funwun/eink_test/images/eink_test_setup.jpg

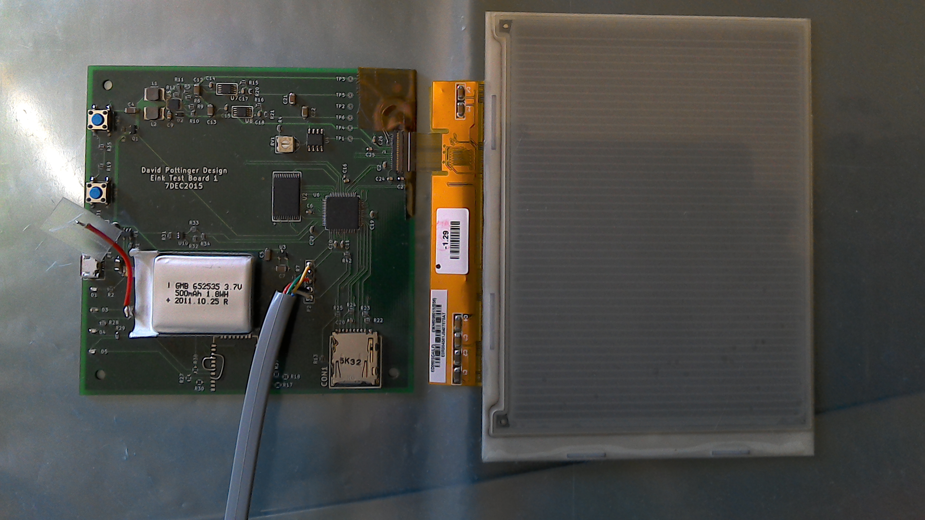
images/eink_test_setup.jpg
