funwun/eink_test/images/eink_raw_boards.jpg

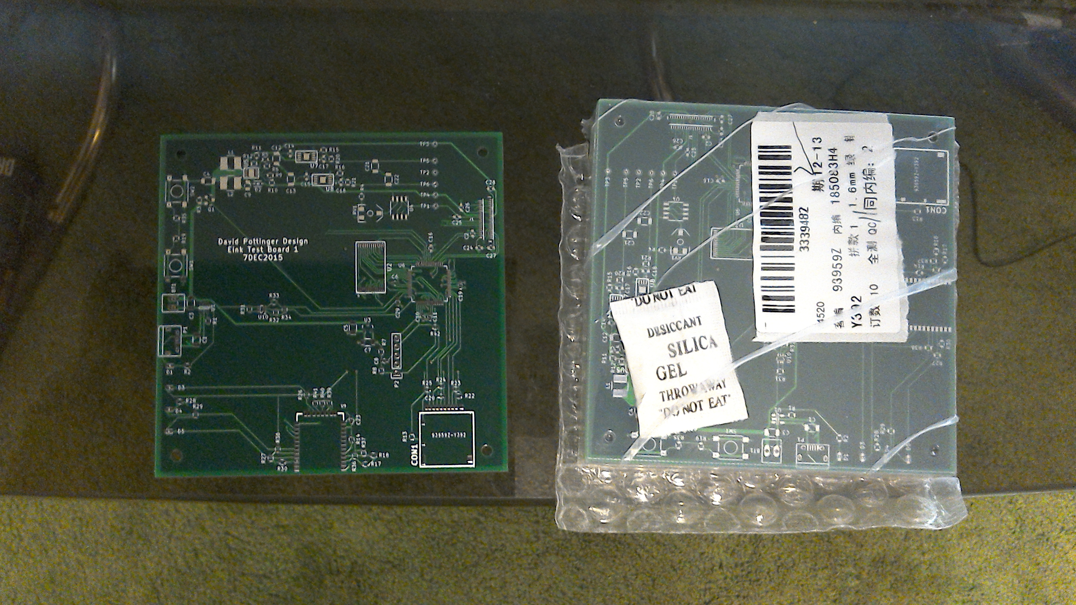
images/eink_raw_boards.jpg
