funwun/eink_test/images/eink_layout_1.png

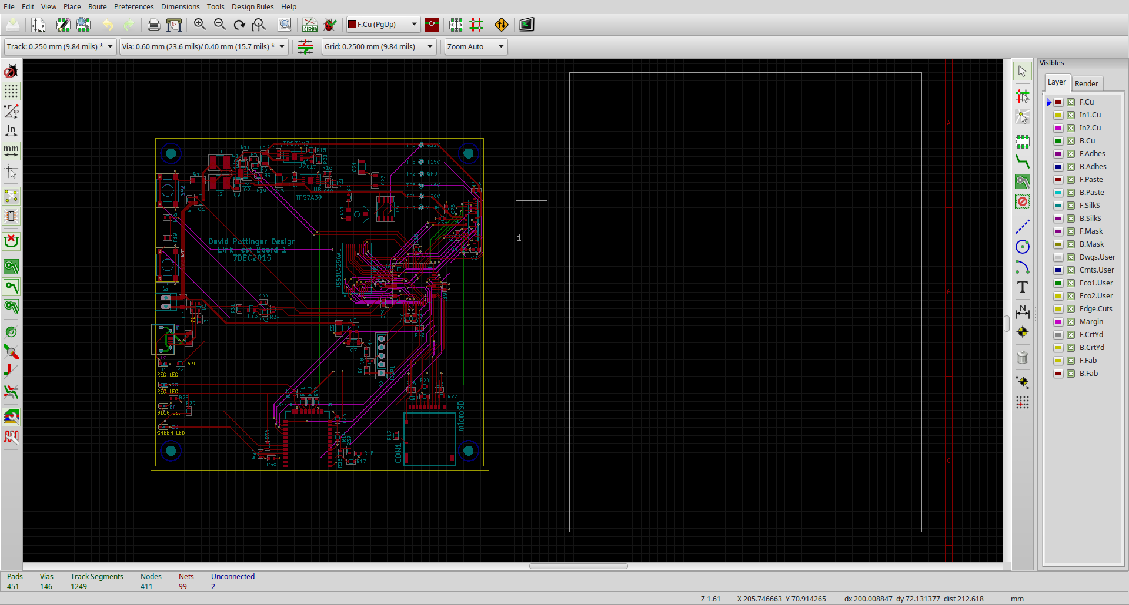
images/eink_layout_1.png
