funwun/eink_test/images/eink_schematic_1.png

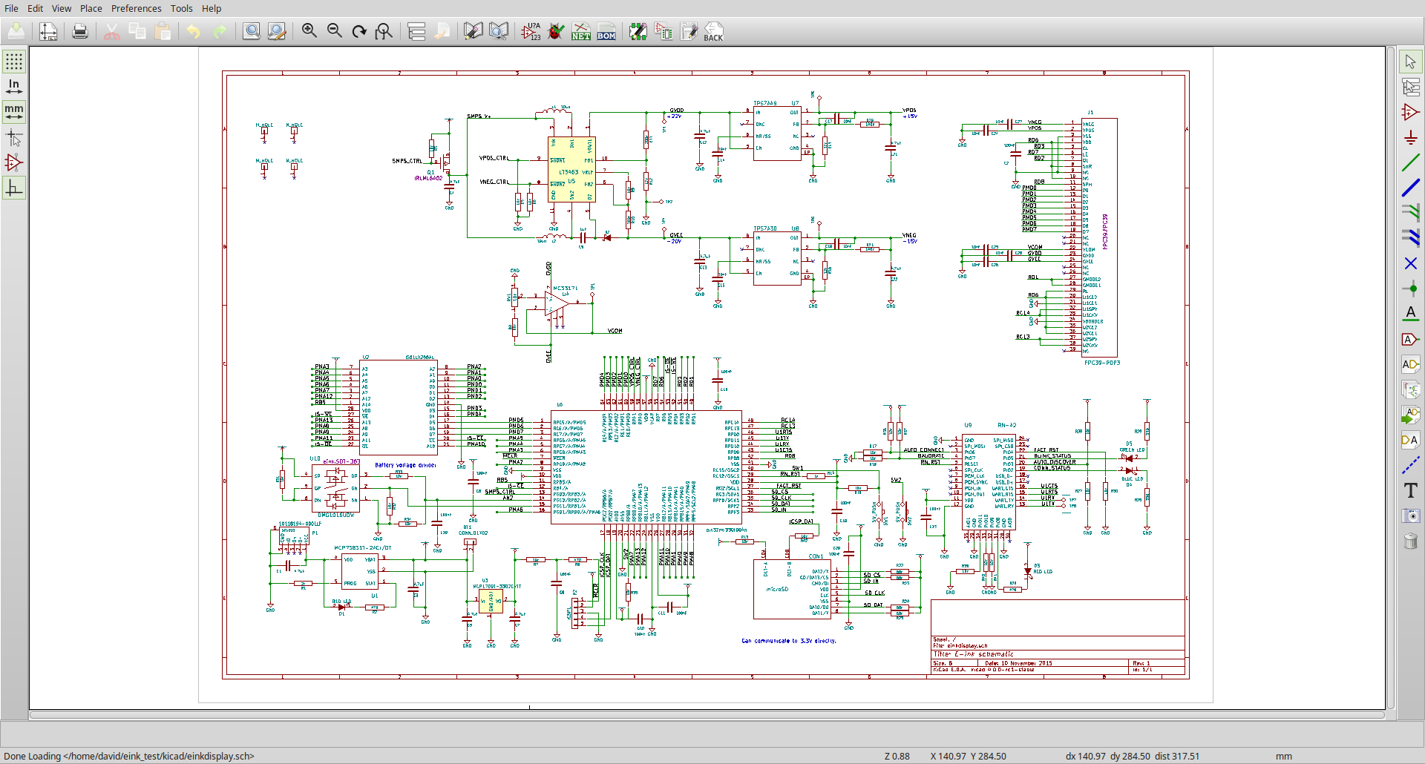
images/eink_schematic_1.png
