funwun/eink_test/kicad/RN-42.dxf

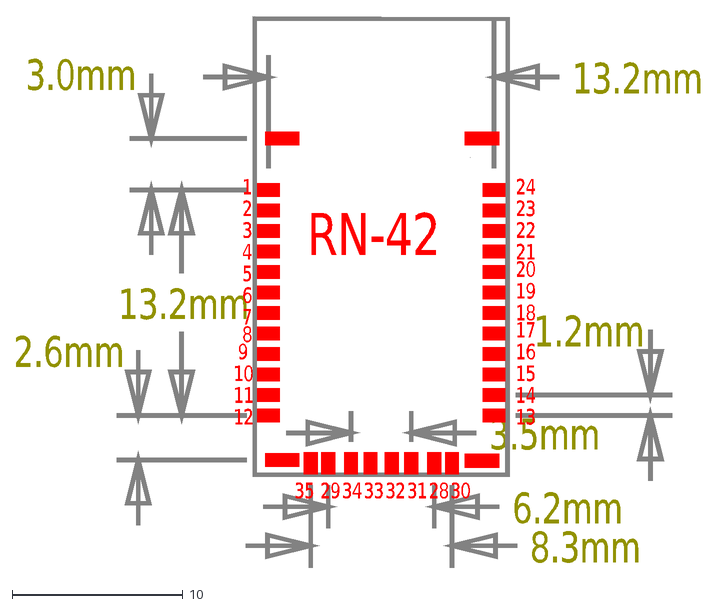
[picture p5: CAD file, 2016-03-12]
kicad/RN-42.dxf
13.2mm
1.2mm
2.6mm
3.0mm
8.3mm
6.2mm
3.5mm
1
2
3
4
5
6
7
8
9
10
11
12
24
23
22
21
20
19
18
14
13
15
17
16
35
29
34
33
32
31
28
30
RN-42
