funwun/eink_test/(list of files, drawings)

Other design files:
kicad/Dwl-Altium-PCB-Footprint-Library.pcblib
