funwun/eink_test/kicad/einkdisplay.kicad_pcb

## KiCad design kicad/einkdisplay.kicad_pcb (2016-03-12)

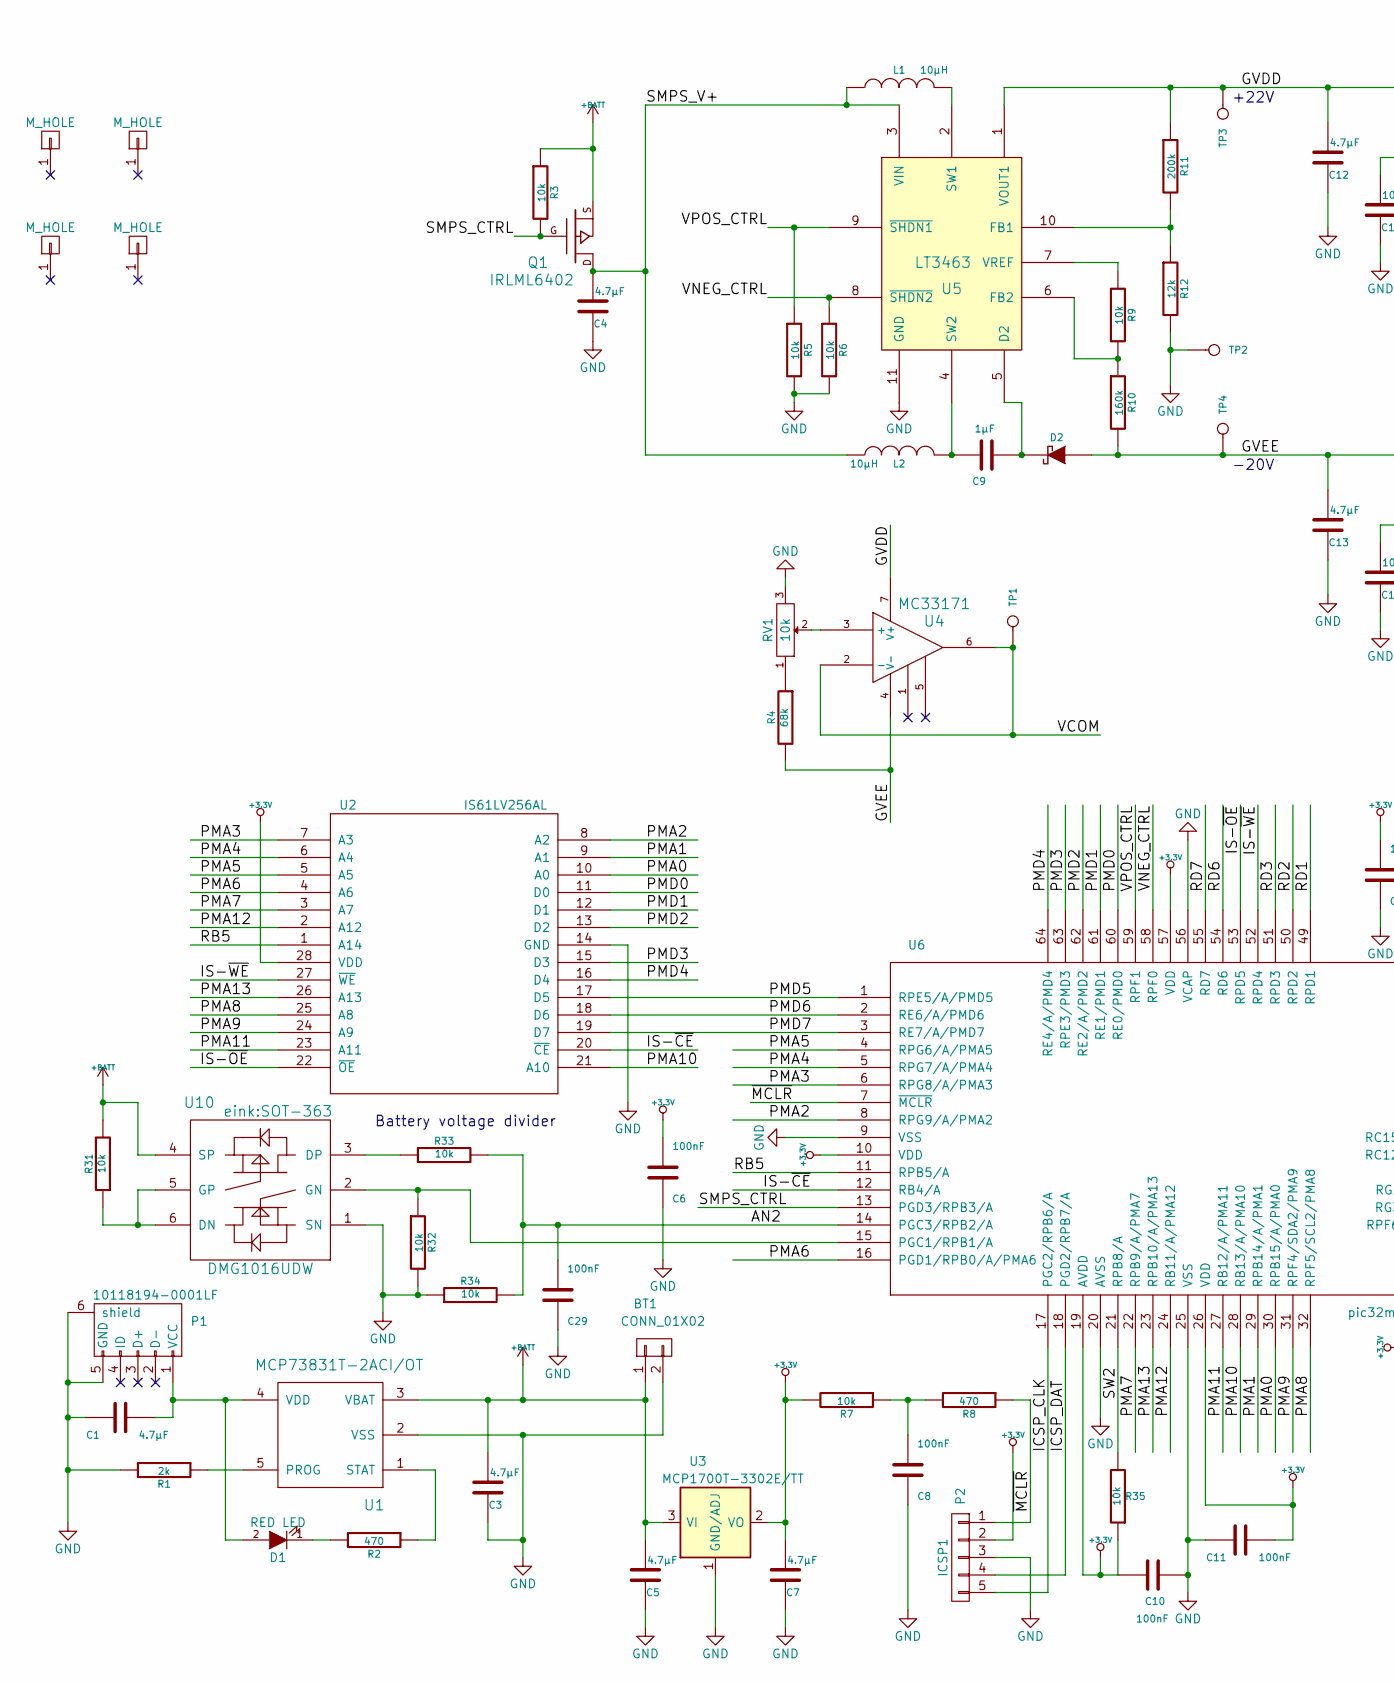
[picture p6: schematic einkdisplay.sch, E-ink schematic, part in row 1, column 1]

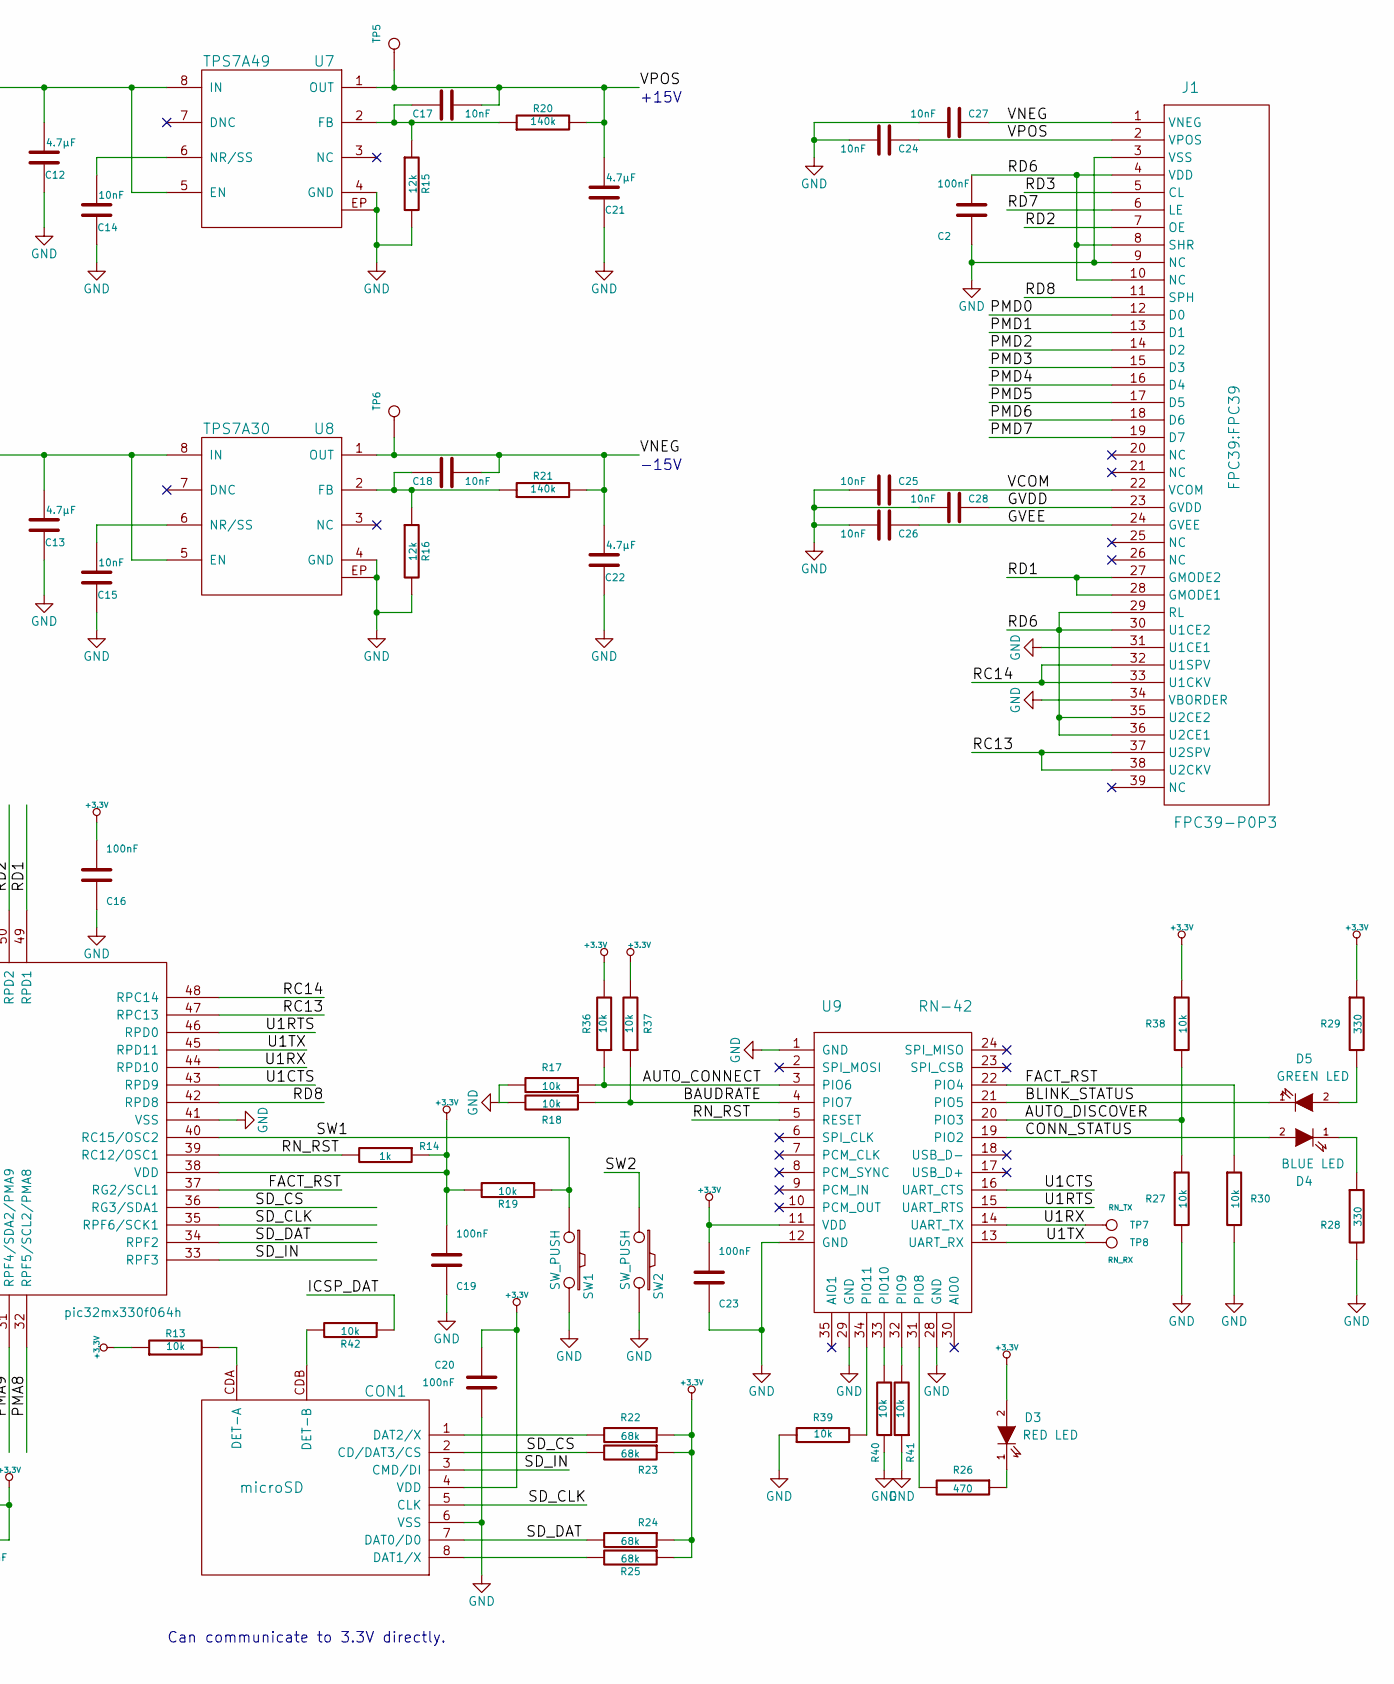
[picture p7: schematic einkdisplay.sch, E-ink schematic, part in row 1, column 2]

Parts:
BT1: CONN_01X02; PINHEAD1-2
C1, C3, C4, C5, C7, C12, C13, C21, C22: 4.7µF; C_1206; Rating 50V; MFG_PN UMK316AB7475KL-T
C2, C6, C8, C10, C11, C16, C19, C20, C23, C29: 100nF; C_0603
C9: 1µF; C_0805; Rating 50V; MFG_PN GRM219R61H105KA73D
C14, C15, C17, C18, C24, C25, C26, C27, C28: 10nF; C_0603; Rating 50V; MFG_PN GRM188R71H103KA01D
CON1: microSD; microSD_std_top; MFG_PN DM3AT-SF-PEJM5
D1, D3: RED LED; LED-0603
D2: DIODESCH; SOD-323-inv; MFG_PN 1N4148WX-TP
D4: BLUE LED; LED-0603
D5: GREEN LED; LED-0603
J1: FPC39-P0P3; FPC39; MFG_PN FH26-39S-0.3SHW(05)
L1, L2: 10µH; NR4018_HandSoldering; MFG_PN LQH44PN100MP0L
MH1, MH2, MH3, MH4: M_HOLE; MountingHole_3mm
P1: 10118194-0001LF; USB_Micro-B; MFG_PN 10118194-0001LF
P2: ICSP1; Pin_Header_Straight_1x05
Q1: 3A; SOT-23_IRLML6402; MFG_PN IRLML6402
R1: 2k; R_0603
R2, R8, R26: 470; R_0603
R3, R5, R6, R7, R9, R13, R17, R18, R19, R27, R30, R31, R32, R33, R34, R35, R36, R37, R38, R39, R40, R41, R42: 10k; R_0603
R4, R22, R23, R24, R25: 68k; R_0603
R10: 160k; R_0603
R11: 200k; R_0603
R12, R15, R16: 12k; R_0603
R14: 1k; R_0603
R20, R21: 140k; R_0603
R28, R29: 330; R_0603
RV1: 10k; POT_SMD; MFG_PN 3314G-1-103E
SW1, SW2: SW_PUSH; SW_SPST_PTS645; MFG_PN PTS645SM43SMTR92 LFS
TP1: VCOM; PINTST
TP2: GND; PINTST
TP3: +22V; PINTST
TP4: -20V; PINTST
TP5: +15V; PINTST
TP6: -15V; PINTST
TP7: RN_TX; PINTST
TP8: RN_RX; PINTST
U1: MCP73831T-2ACI/OT; SOT-23-5
U2: IS61LV256AL; 28TSOP-I; MFG_PN IS61LV256AL-10TLI
U3: MCP1700T-3302E/TT; SOT-23
U4: MC33171; SOIC-8_3.9x4.9mm_Pitch1.27mm; MFG_PN MC33171DT
U5: LT3463; 10DFN-3x3; MFG_PN LT3463EDD#PBF
U6: pic32mx330f064h; LQFP-64_10x10mm_Pitch0.5mm
U7: TPS7A49; 8MSOP; MFG_PN TPS7A4901DGNR
U8: TPS7A30; 8MSOP; MFG_PN TPS7A3001DGNR
U9: RN-42; RN-41; MFG_PN RN42-I/RM
U10: DMG1016UDW; SOT-363; MFG_PN DMG1016UDW-7

Connections:
+3.3V: C6.1, C7.1, C10.2, C11.1, C16.1, C19.1, C20.2, C23.1, CON1.4 (VDD), D3.2 (A), P2.2, R7.2, R13.1, R14.1, R19.2, R22.1, R23.1, R24.1, R25.1, R29.1, R35.1, R36.2, R37.2, R38.1, U2.28 (VDD), U3.2 (VO), U6.10 (VDD), U6.19 (AVDD), U6.26 (VDD), U6.38 (VDD), U6.57 (VDD), U9.11 (VDD); also elsewhere on the board
+BATT: BT1.1, C3.1, C5.1, Q1.S, R3.1, R31.2, U1.3 (VBAT), U3.3 (VI), U10.4 (SP)
/AN2: C29.1, R33.2, R34.2, U6.14 (PGC3/RPB2/A)
/AUTO_CONNECT: R17.1, R36.1, U9.3 (PIO6)
/AUTO_DISCOVER: R27.1, R38.2, U9.20 (PIO3)
/BAUDRATE: R18.1, R37.1, U9.4 (PIO7)
/BLINK_STATUS: D5.1 (K), U9.21 (PIO5); also elsewhere on the board
/CONN_STATUS: D4.2 (A), U9.19 (PIO2); also elsewhere on the board
/FACT_RST: R30.1, U6.37 (RG2/SCL1), U9.22 (PIO4)
/GVDD: C12.1, C28.2, J1.23 (GVDD), R11.1, TP3.1, U4.7 (V+), U5.1 (VOUT1), U7.5 (EN), U7.8 (IN)
/GVEE: C13.1, C26.2, D2.1 (A), J1.24 (GVEE), R4.2, R10.2, TP4.1, U4.4 (V-), U8.5 (EN), U8.8 (IN)
/ICSP_CLK: P2.5, U6.17 (PGC2/RPB6/A)
/ICSP_DAT: P2.4, R42.1, U6.18 (PGD2/RPB7/A)
/IS-~CE: U2.20 (~CE), U6.12 (RB4/A)
/IS-~OE: U2.22 (~OE), U6.53 (RPD5)
/IS-~WE: U2.27 (~WE), U6.52 (RPD4)
/PMA0: U2.10 (A0), U6.30 (RPB15/A/PMA0)
/PMA1: U2.9 (A1), U6.29 (RPB14/A/PMA1)
/PMA2: U2.8 (A2), U6.8 (RPG9/A/PMA2)
/PMA3: U2.7 (A3), U6.6 (RPG8/A/PMA3)
/PMA4: U2.6 (A4), U6.5 (RPG7/A/PMA4)
/PMA5: U2.5 (A5), U6.4 (RPG6/A/PMA5)
/PMA6: U2.4 (A6), U6.16 (PGD1/RPB0/A/PMA6)
/PMA7: U2.3 (A7), U6.22 (RPB9/A/PMA7)
/PMA8: U2.25 (A8), U6.32 (RPF5/SCL2/PMA8)
/PMA9: U2.24 (A9), U6.31 (RPF4/SDA2/PMA9)
/PMA10: U2.21 (A10), U6.28 (RB13/A/PMA10)
/PMA11: U2.23 (A11), U6.27 (RB12/A/PMA11)
/PMA12: U2.2 (A12), U6.24 (RB11/A/PMA12)
/PMA13: U2.26 (A13), U6.23 (RPB10/A/PMA13)
/PMD0: J1.12 (D0), U2.11 (D0), U6.60 (RE0/PMD0)
/PMD1: J1.13 (D1), U2.12 (D1), U6.61 (RE1/PMD1)
/PMD2: J1.14 (D2), U2.13 (D2), U6.62 (RE2/A/PMD2)
/PMD3: J1.15 (D3), U2.15 (D3), U6.63 (RPE3/PMD3)
/PMD4: J1.16 (D4), U2.16 (D4), U6.64 (RE4/A/PMD4)
/PMD5: J1.17 (D5), U2.17 (D5), U6.1 (RPE5/A/PMD5)
/PMD6: J1.18 (D6), U2.18 (D6), U6.2 (RE6/A/PMD6)
/PMD7: J1.19 (D7), U2.19 (D7), U6.3 (RE7/A/PMD7)
/RB5: U2.1 (A14), U6.11 (RPB5/A)
/RC13: J1.37 (U2SPV), J1.38 (U2CKV), U6.47 (RPC13)
/RC14: J1.32 (U1SPV), J1.33 (U1CKV), U6.48 (RPC14)
/RD1: J1.27 (GMODE2), J1.28 (GMODE1), U6.49 (RPD1)
/RD2: J1.7 (OE), U6.50 (RPD2)
/RD3: J1.5 (CL), U6.51 (RPD3)
/RD6: C2.1, J1.4 (VDD), J1.8 (SHR), J1.10 (NC), J1.29 (RL), J1.30 (U1CE2), J1.35 (U2CE2), J1.36 (U2CE1), U6.54 (RD6)
/RD7: J1.6 (LE), U6.55 (RD7)
/RD8: J1.11 (SPH), U6.42 (RPD8)
/RN_RST: R14.2, U6.39 (RC12/OSC1), U9.5 (RESET)
/SD_CLK: CON1.5 (CLK), U6.35 (RPF6/SCK1)
/SD_CS: CON1.2 (CD/DAT3/CS), R23.2, U6.36 (RG3/SDA1)
/SD_DAT: CON1.7 (DAT0/D0), R24.2, U6.34 (RPF2)
/SD_IN: CON1.3 (CMD/DI), U6.33 (RPF3)
/SMPS_CTRL: Q1.G, R3.2, U6.13 (PGD3/RPB3/A)
/SMPS_V+: C4.1, L1.1, L2.1, Q1.D, U5.3 (VIN)
/SW1: R19.1, SW1.1, U6.40 (RC15/OSC2); also elsewhere on the board
/SW2: R35.2, SW2.1, U6.21 (RPB8/A); also elsewhere on the board
/U1CTS: U6.43 (RPD9), U9.16 (UART_CTS)
/U1RTS: U6.46 (RPD0), U9.15 (UART_RTS)
/VCOM: C25.2, J1.22 (VCOM), TP1.1, U4.2 (-), U4.6
/VNEG: C18.1, C22.1, C27.2, J1.1 (VNEG), R21.2, TP6.1, U8.1 (OUT)
/VNEG_CTRL: R6.1, U5.8 (~SHDN2), U6.58 (RPF0)
/VPOS: C17.1, C21.1, C24.2, J1.2 (VPOS), R20.2, TP5.1, U7.1 (OUT)
/VPOS_CTRL: R5.1, U5.9 (~SHDN1), U6.59 (RPF1)
/~MCLR: P2.1, R8.1, U6.7 (~MCLR)
GND: BT1.2, C1.2, C2.2, C3.2, C4.2, C5.2, C6.2, C7.2, C8.2, C10.1, C11.2, C12.2, C13.2, C14.2, C15.2, C16.2, C19.2, C20.1, C21.2, C22.2, C23.2, C24.1, C25.1, C26.1, C27.1, C28.1, C29.2, CON1.6 (VSS), J1.3 (VSS), J1.9 (NC), J1.31 (U1CE1), J1.34 (VBORDER), P1.5 (GND), P1.6 (shield), P2.3, R1.2, R5.2, R6.2, R12.2, R15.2, R16.2, R17.2, R18.2, R27.2, R28.2, R30.2, R32.2, R34.1, R39.1, R40.1, R41.1, RV1.3, SW1.2, SW2.2, TP2.1, U1.2 (VSS), U2.14 (GND), U3.1 (GND/ADJ), U5.11 (GND), U6.9 (VSS), U6.20 (AVSS), U6.25 (VSS), U6.41 (VSS), U6.56 (VCAP), U7.4 (GND), U7.EP, U8.4 (GND), U8.EP, U9.1 (GND), U9.12 (GND), U9.28 (GND), U9.29 (GND), U10.1 (SN); also elsewhere on the board
unnamed 65: C1.1, D1.2 (A), P1.1 (VCC), U1.4 (VDD); also elsewhere on the board
unnamed: C8.1, R7.1, R8.2
unnamed: C9.1, L2.2, U5.4 (SW2)
unnamed: C9.2, D2.2 (K), U5.5 (D2)
unnamed: C14.1, U7.6 (NR/SS)
unnamed: C15.1, U8.6 (NR/SS)
unnamed: C17.2, R15.1, R20.1, U7.2 (FB)
unnamed: C18.2, R16.1, R21.1, U8.2 (FB)
unnamed: CON1.1 (DAT2/X), R22.2
unnamed: CON1.8 (DAT1/X), R25.2
unnamed: CON1.CDA (DET-A), R13.2
unnamed: CON1.CDB (DET-B), R42.2
unnamed 77: D1.1 (K), R2.2; also elsewhere on the board
unnamed 78: D3.1 (K), R26.1; also elsewhere on the board
unnamed 79: D4.1 (K), R28.1; also elsewhere on the board
unnamed 80: D5.2 (A), R29.2; also elsewhere on the board
unnamed: L1.2, U5.2 (SW1)
unnamed: R1.1, U1.5 (PROG)
unnamed: R2.1, U1.1 (STAT)
unnamed: R4.1, RV1.1
unnamed: R9.1, U5.7 (VREF)
unnamed: R9.2, R10.1, U5.6 (FB2)
unnamed: R11.2, R12.1, U5.10 (FB1)
unnamed: R26.2, U9.31 (PIO8)
unnamed: R31.1, U10.5 (GP), U10.6 (DN)
unnamed: R32.1, U6.15 (PGC1/RPB1/A), U10.2 (GN)
unnamed: R33.1, U10.3 (DP)
unnamed: R39.2, U9.34 (PIO11)
unnamed: R40.2, U9.33 (PIO10)
unnamed: R41.2, U9.32 (PIO9)
unnamed: RV1.2, U4.3 (+)

Notes on the sheet:
+15V
-15V
-20V
+22V
Can communicate to 3.3V directly.
Battery voltage divider

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
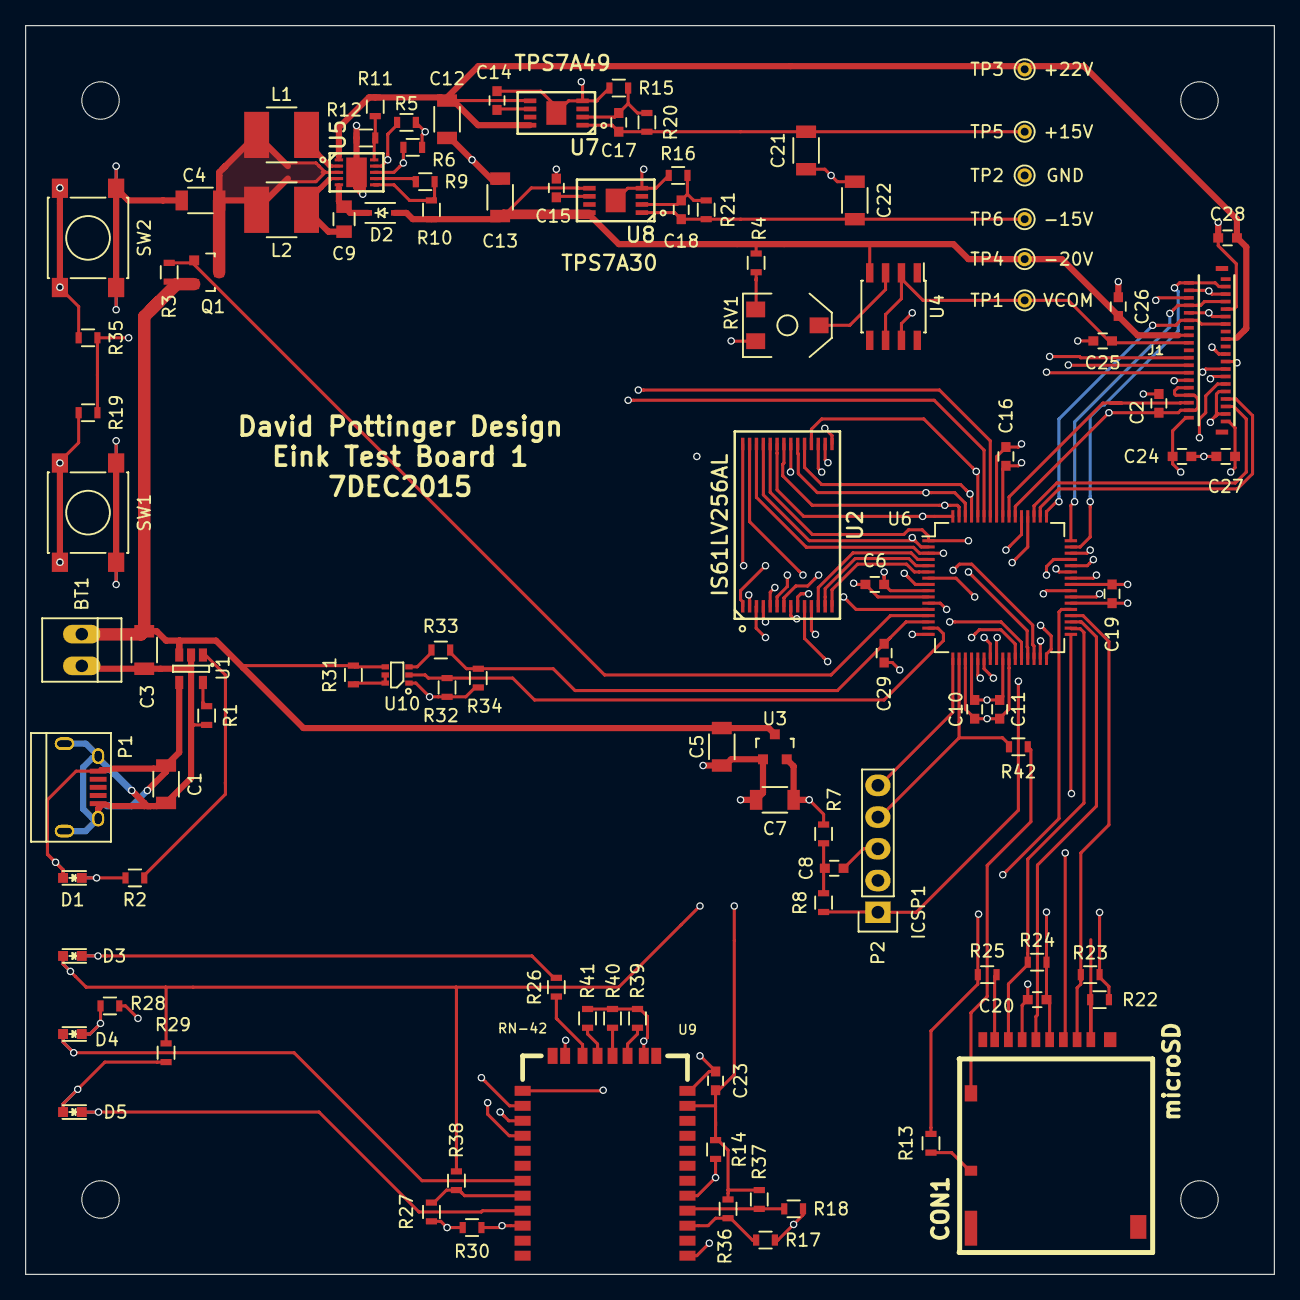
[picture p8: board einkdisplay.kicad_pcb from above]

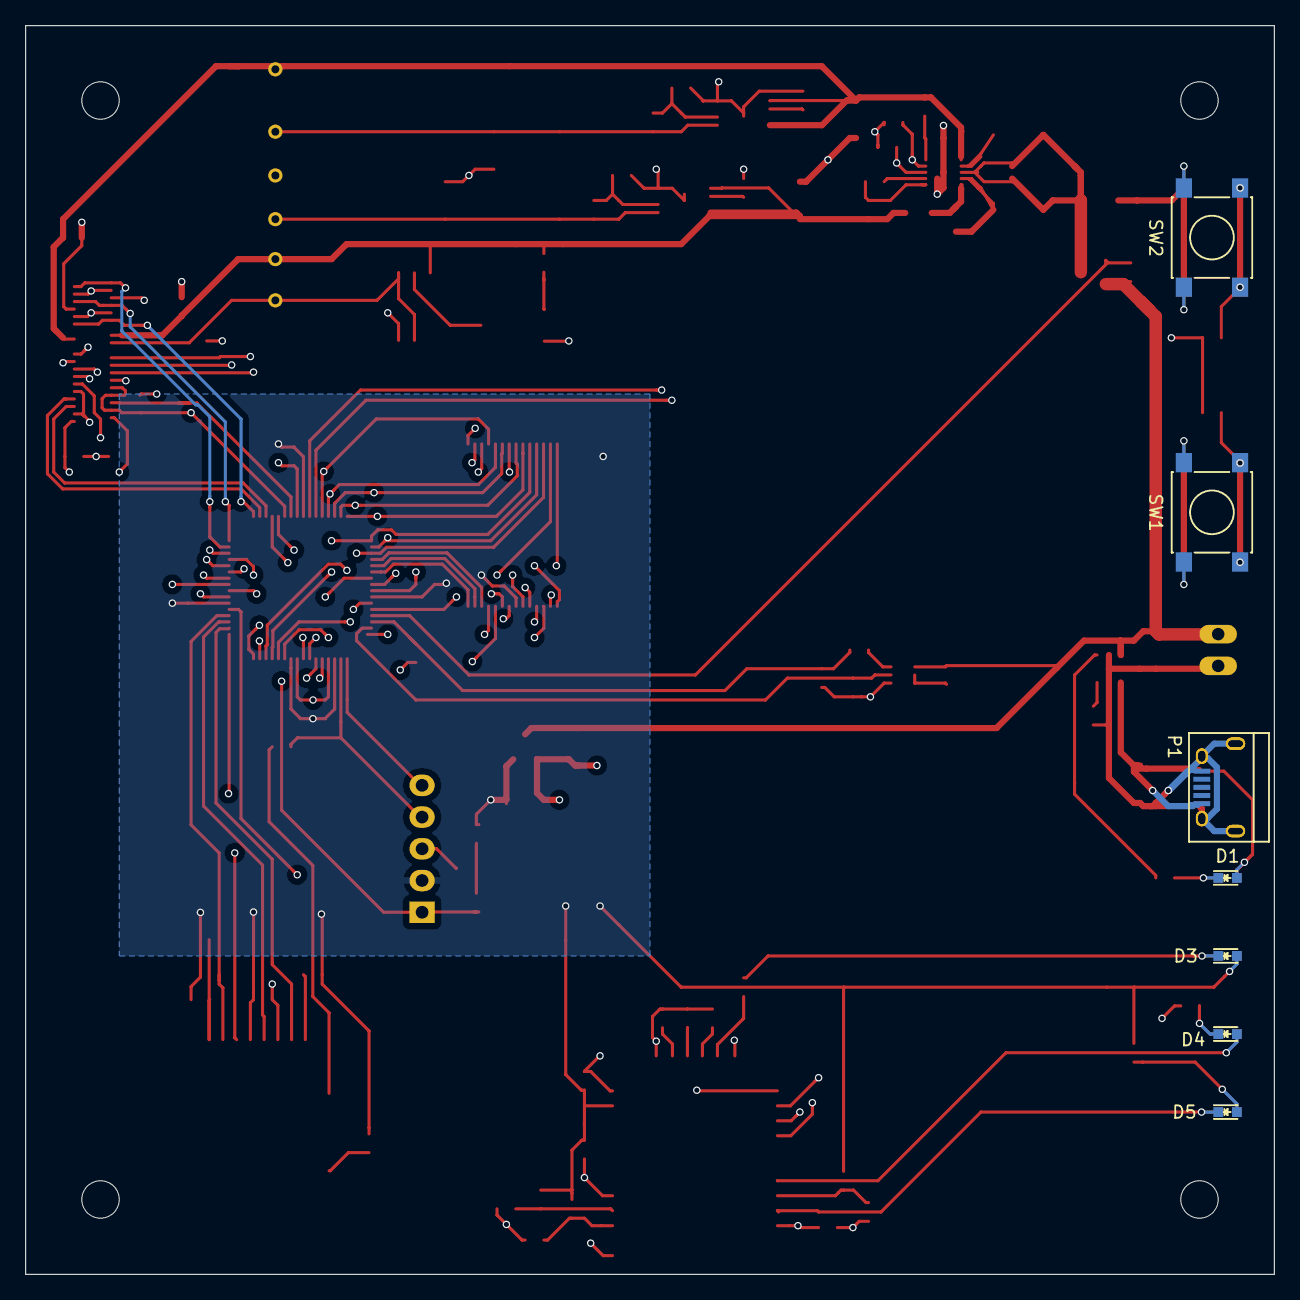
[picture p9: board einkdisplay.kicad_pcb from below]

Board: 4 copper layers, 100.0 x 100.0 mm, 114 parts (7 on the bottom side), 98 nets.

Other parts of the board:
D1#2, D3#2: RED LED; LED-0603
D4#2: BLUE LED; LED-0603
D5#2: GREEN LED; LED-0603
P1#2: 10118194-0001LF; USB_Micro-B
SW1#2, SW2#2: SW_PUSH; SW_SPST_PTS645

Their connections:
+3.3V: D3#2.2; also elsewhere on the board
/BLINK_STATUS: D5#2.1; also elsewhere on the board
/CONN_STATUS: D4#2.2; also elsewhere on the board
/SW1: SW1#2.1; also elsewhere on the board
/SW2: SW2#2.1; also elsewhere on the board
GND: P1#2.5, P1#2.6, SW1#2.2, SW2#2.2; also elsewhere on the board
unnamed 65: D1#2.2, P1#2.1; also elsewhere on the board
unnamed 77: D1#2.1; also elsewhere on the board
unnamed 78: D3#2.1; also elsewhere on the board
unnamed 79: D4#2.1; also elsewhere on the board
unnamed 80: D5#2.2; also elsewhere on the board
